rrruark/nixon_phone/readme

The project writeup can be found here: http://robruark.com/projects/nixon_phone/nixon_phone.html
