rrruark/nixon_phone/end_plate_pcb/nixon.bmp

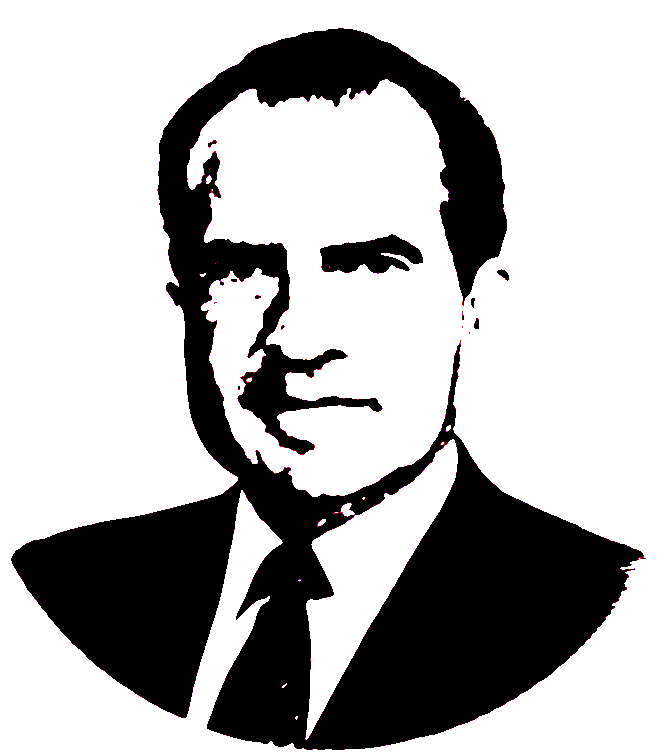
end_plate_pcb/nixon.bmp
