rrruark/nixon_phone/nixon.pdf

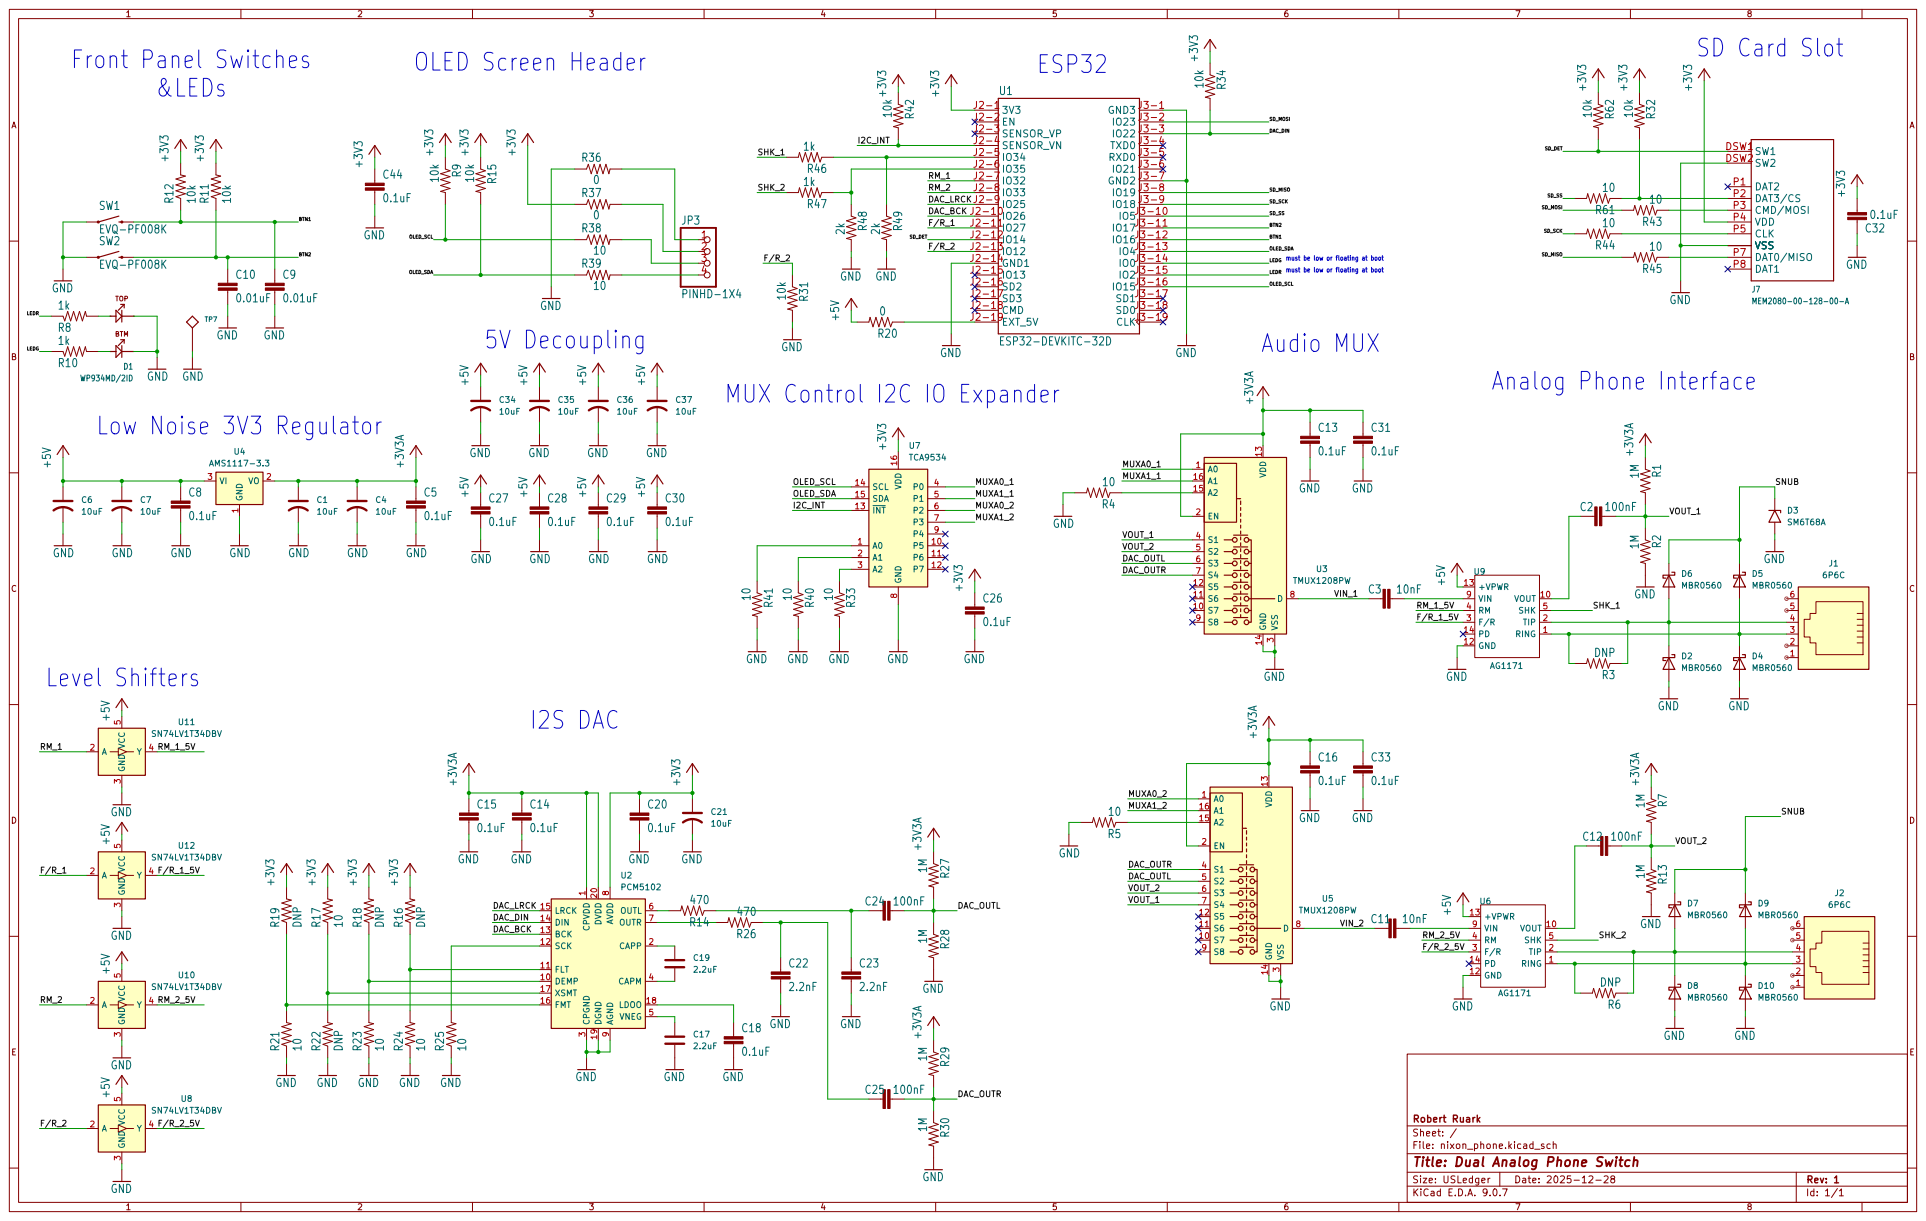
[picture p2: page 1]
