rrruark/nixon_phone/PCB/nixon_phone.kicad_pcb

## KiCad design PCB/nixon_phone.kicad_pcb (2026-05-17)

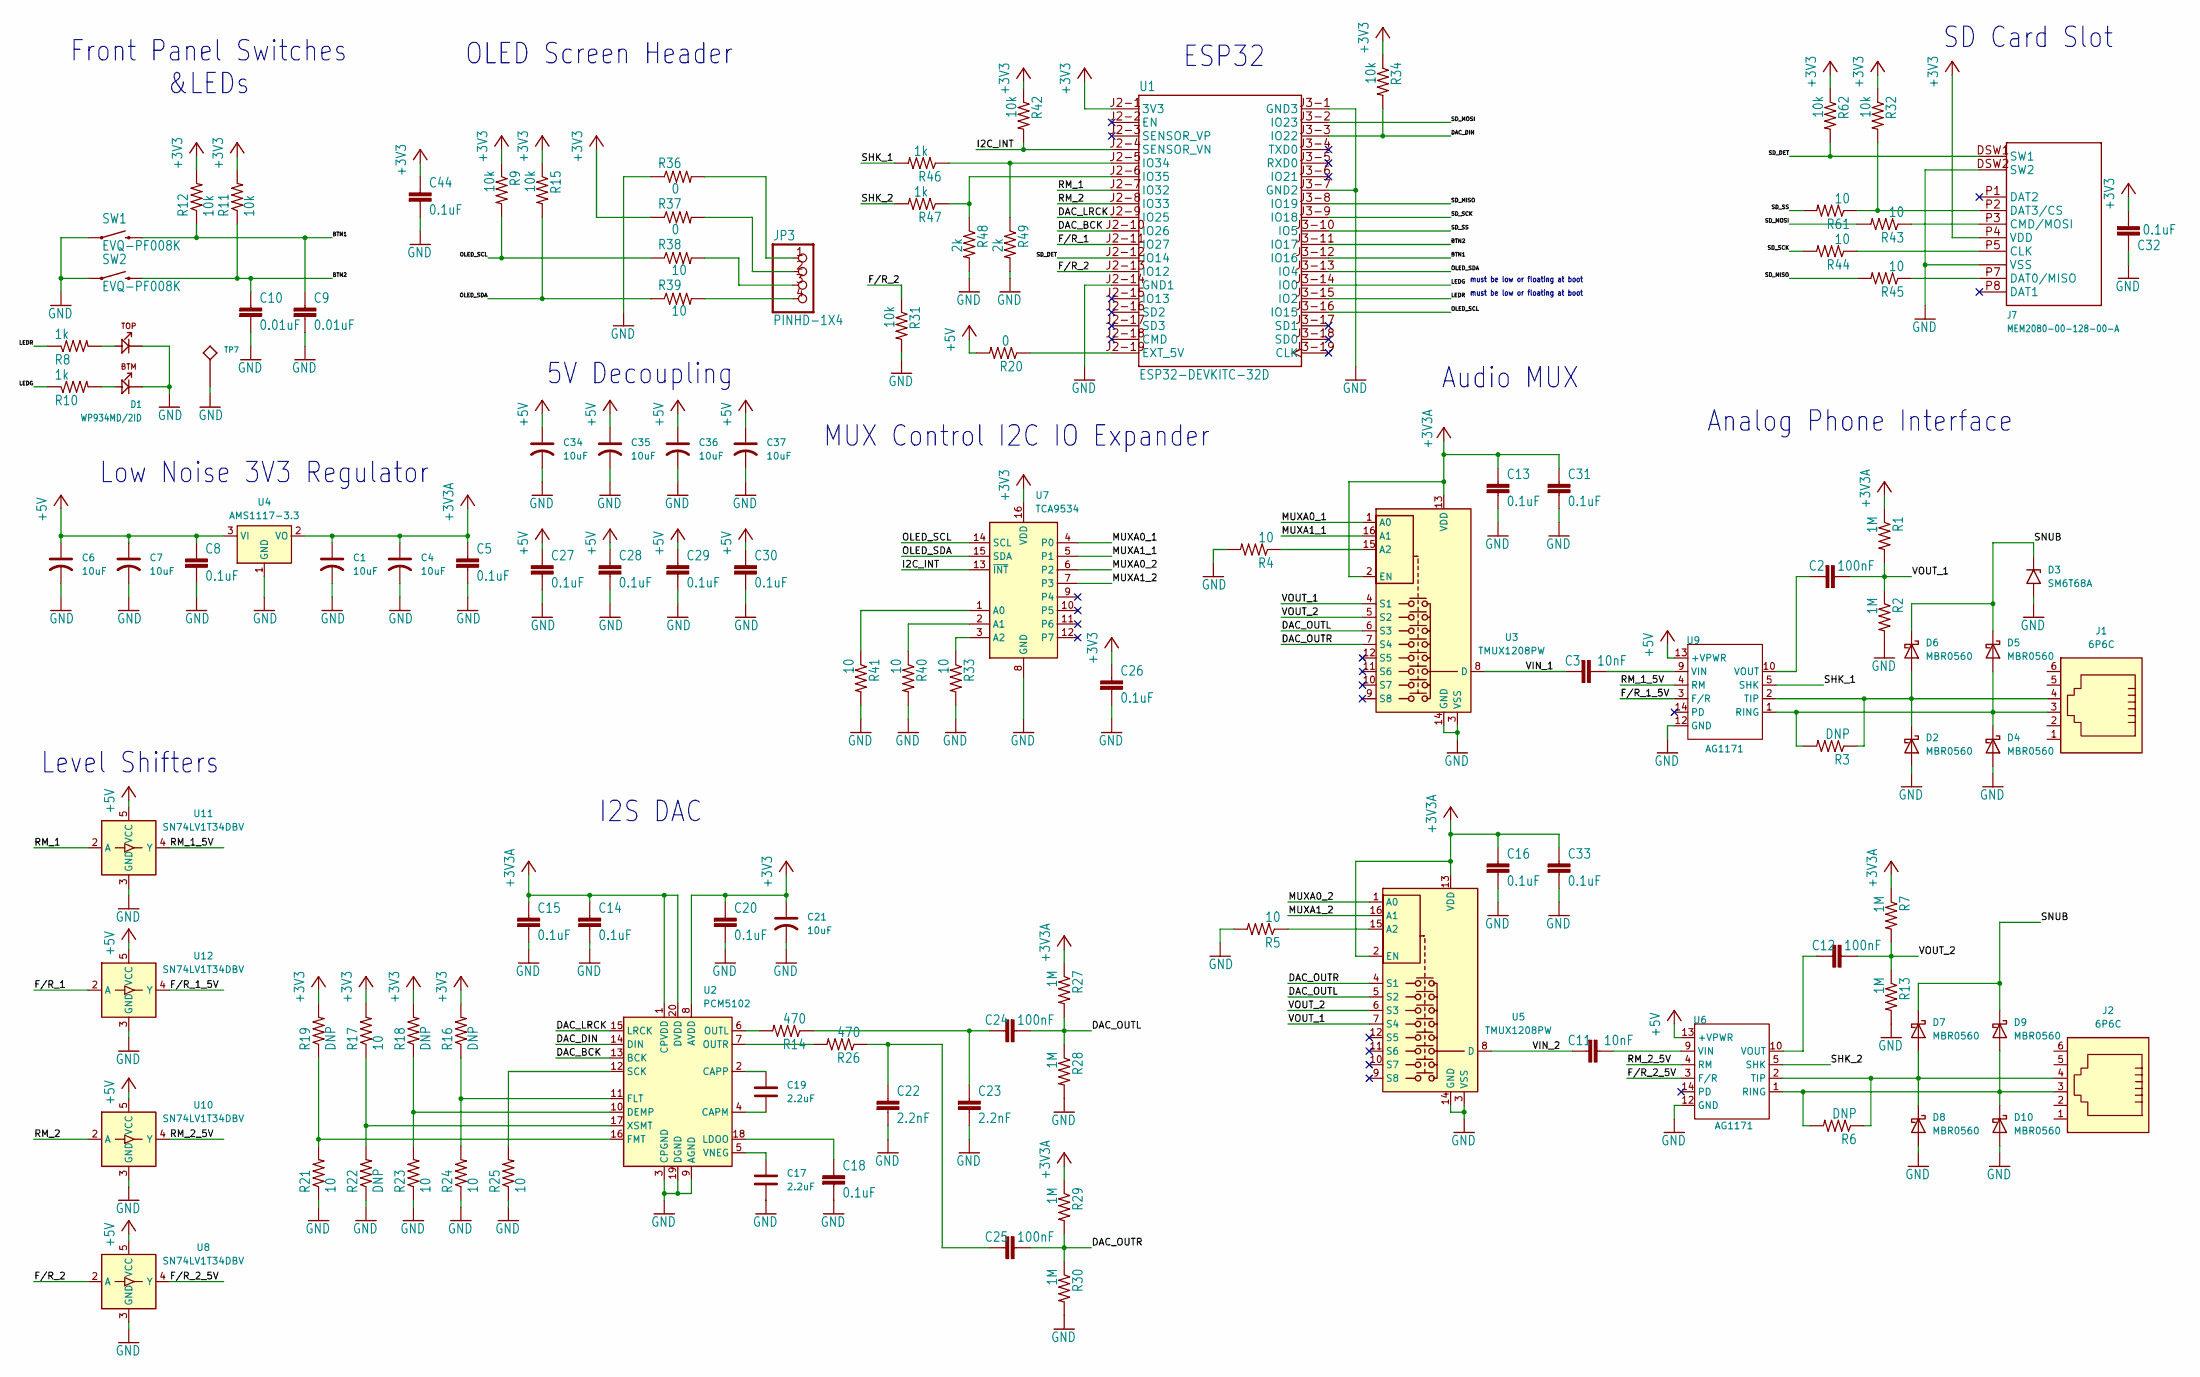
[picture p3: schematic nixon_phone.kicad_sch, Dual Analog Phone Switch]

Parts:
C1, C4, C6, C7, C21, C34, C35, C36, C37: 10uF; C_1206_3216Metric_Pad1.33x1.80mm_HandSolder
C2, C12, C24, C25: 100nF; 0603
C3, C11: 10nF; 0603
C5, C8, C13, C14, C15, C16, C18, C20, C26, C27, C28, C29, C30, C31, C32, C33, C44: 0.1uF; 0603
C9, C10: 0.01uF; 0603
C17, C19: 2.2uF; C_0805_2012Metric
C22, C23: 2.2nF; 0603
D1: WP934MD/2ID; WP934MD_2ID
D2, D4, D5, D6, D7, D8, D9, D10: MBR0560; D_SOD-123
D3: SM6T68A; D_SMB
J1, J2: 6P6C; RJ12_Amphenol_54601-x06_Horizontal
J7: MEM2080-00-128-00-A; MEM2080
JP3: PINHD-1X4; 1X04
R1, R2, R7, R13, R27, R28, R29, R30: 1M; 0603
R3, R6, R16, R18, R19, R22: DNP; 0603
R4, R5, R17, R21, R23, R24, R25, R33, R38, R39, R40, R41, R43, R44, R45, R61: 10; 0603
R8, R10, R46, R47: 1k; 0603
R9, R11, R12, R15, R31, R32, R34, R42, R62: 10k; 0603
R14, R26: 470; 0603
R20, R36, R37: 0; 0603
R48, R49: 2k; 0603
SW1, SW2: EVQ-PF008K
TP7: 5011; 5010
U1: ESP32-DEVKITC-32D; MODULE_ESP32-DEVKITC-32D
U2: PCM5102; TSSOP-20_4.4x6.5mm_P0.65mm
U3, U5: TMUX1208PW; TSSOP-16_4.4x5mm_P0.65mm
U4: AMS1117-3.3; SOT-223-3_TabPin2
U6, U9: AG1171; SIP-18
U7: TCA9534; TSSOP-16_4.4x5mm_P0.65mm
U8, U10, U11, U12: SN74LV1T34DBV; SOT-23-5

Connections:
+3V3: C20.1, C21.1, C26.1, C32.2, C44.1, J7.P4 (VDD), R9.1, R11.2, R12.2, R15.1, R16.2, R17.2, R18.2, R19.2, R32.1, R34.1, R37.1, R42.1, R62.1, U1.J2-1 (3V3), U2.8 (AVDD), U7.16 (VDD)
+3V3A: C1.1, C4.1, C5.1, C13.1, C14.1, C15.1, C16.1, C31.1, C33.1, R1.1, R7.1, R27.1, R29.1, U2.1 (CPVDD), U2.20 (DVDD), U3.2 (EN), U3.13 (VDD), U4.2 (VO), U5.2 (EN), U5.13 (VDD)
+5V: C6.1, C7.1, C8.1, C27.1, C28.1, C29.1, C30.1, C34.1, C35.1, C36.1, C37.1, R20.2, U4.3 (VI), U6.13 (+VPWR), U8.5 (VCC), U9.13 (+VPWR), U10.5 (VCC), U11.5 (VCC), U12.5 (VCC)
/BTN1: C9.1, R12.1, SW1.S2 (2), U1.J3-12 (IO16)
/BTN2: C10.1, R11.1, SW2.S2 (2), U1.J3-11 (IO17)
/DAC_BCK: U1.J2-10 (IO26), U2.13 (BCK)
/DAC_DIN: R34.2, U1.J3-3 (IO22), U2.14 (DIN)
/DAC_LRCK: U1.J2-9 (IO25), U2.15 (LRCK)
/DAC_OUTL: C24.1, R27.2, R28.1, U3.6 (S3), U5.5 (S2)
/DAC_OUTR: C25.1, R29.2, R30.1, U3.7 (S4), U5.4 (S1)
/F/R_1: U1.J2-11 (IO27), U12.2 (A)
/F/R_1_5V: U9.3 (F/R), U12.4 (Y)
/F/R_2: R31.1, U1.J2-13 (IO12), U8.2 (A)
/F/R_2_5V: U6.3 (F/R), U8.4 (Y)
/I2C_INT: R42.2, U1.J2-4 (SENSOR_VN), U7.13 (~INT)
/LEDG: R10.1, U1.J3-14 (IO0)
/LEDR: R8.1, U1.J3-15 (IO2)
/MUXA0_1: U3.1 (A0), U7.4 (P0)
/MUXA0_2: U5.1 (A0), U7.6 (P2)
/MUXA1_1: U3.16 (A1), U7.5 (P1)
/MUXA1_2: U5.16 (A1), U7.7 (P3)
/OLED_SCL: R9.2, R38.1, U1.J3-16 (IO15), U7.14 (SCL)
/OLED_SDA: R15.2, R39.1, U1.J3-13 (IO4), U7.15 (SDA)
/RM_1: U1.J2-7 (IO32), U11.2 (A)
/RM_1_5V: U9.4 (RM), U11.4 (Y)
/RM_2: U1.J2-8 (IO33), U10.2 (A)
/RM_2_5V: U6.4 (RM), U10.4 (Y)
/SD_DET: J7.DSW1 (SW1), R62.2, U1.J2-12 (IO14)
/SD_MISO: R45.2, U1.J3-8 (IO19)
/SD_MOSI: R43.2, U1.J3-2 (IO23)
/SD_SCK: R44.2, U1.J3-9 (IO18)
/SD_SS: R61.2, U1.J3-10 (IO5)
/SHK_1: R46.2, U9.5 (SHK)
/SHK_2: R47.2, U6.5 (SHK)
/SNUB: D3.1 (A1), D5.1 (K), D6.1 (K), D7.1 (K), D9.1 (K)
/VIN_1: C3.2, U3.8 (D)
/VIN_2: C11.2, U5.8 (D)
/VOUT_1: C2.1, R1.2, R2.1, U3.4 (S1), U5.7 (S4)
/VOUT_2: C12.1, R7.2, R13.1, U3.5 (S2), U5.6 (S3)
GND: C1.2, C4.2, C5.2, C6.2, C7.2, C8.2, C9.2, C10.2, C13.2, C14.2, C15.2, C16.2, C17.2, C18.2, C20.2, C21.2, C22.2, C23.2, C26.2, C27.2, C28.2, C29.2, C30.2, C31.2, C32.1, C33.2, C34.2, C35.2, C36.2, C37.2, C44.2, D1.K1, D1.K2, D2.2 (A), D3.2 (A2), D4.2 (A), D8.2 (A), D10.2 (A), J7.C1 (VSS), J7.C2 (VSS), J7.C3 (VSS), J7.C4 (VSS), J7.DSW2 (SW2), J7.P6 (VSS), R2.2, R4.2, R5.2, R13.2, R21.1, R22.1, R23.1, R24.1, R25.1, R28.2, R30.2, R31.2, R33.2, R36.1, R40.2, R41.2, R48.2, R49.2, SW1.S1 (1), SW2.S1 (1), TP7.P$1, U1.J2-14 (GND1), U1.J3-1 (GND3), U1.J3-7 (GND2), U2.3 (CPGND), U2.9 (AGND), U2.19 (DGND), U3.3 (VSS), U3.14 (GND), U4.1 (GND), U5.3 (VSS), U5.14 (GND), U6.12 (GND), U7.8 (GND), U8.3 (GND), U9.12 (GND), U10.3 (GND), U11.3 (GND), U12.3 (GND)
unnamed: C22.1, C25.2, R26.1
unnamed: C23.1, C24.2, R14.1
unnamed: D1.A1, R10.2
unnamed: D1.A2, R8.2
unnamed: D2.1 (K), D6.2 (A), J1.4, R3.1, U9.2 (TIP)
unnamed: D4.1 (K), D5.2 (A), J1.3, R3.2, U9.1 (RING)
unnamed: D7.2 (A), D8.1 (K), J2.4, R6.1, U6.2 (TIP)
unnamed: D9.2 (A), D10.1 (K), J2.3, R6.2, U6.1 (RING)
unnamed: J7.P5 (CLK), R44.1
unnamed: J7.P3 (CMD/MOSI), R43.1
unnamed: J7.P7 (DAT0/MISO), R45.1
unnamed: J7.P2 (DAT3/CS), R32.2, R61.1
unnamed: JP3.1, R36.2
unnamed: JP3.2, R37.2
unnamed: JP3.3, R38.2
unnamed: JP3.4, R39.2
unnamed: R20.1, U1.J2-19 (EXT_5V)
unnamed: R46.1, R49.1, U1.J2-5 (IO34)
unnamed: R47.1, R48.1, U1.J2-6 (IO35)
unnamed: C19.2, U2.4 (CAPM)
unnamed: C19.1, U2.2 (CAPP)
unnamed: R18.1, R23.2, U2.10 (DEMP)
unnamed: R16.1, R24.2, U2.11 (FLT)
unnamed: R19.1, R21.2, U2.16 (FMT)
unnamed: C18.1, U2.18 (LDOO)
unnamed: R14.2, U2.6 (OUTL)
unnamed: R26.2, U2.7 (OUTR)
unnamed: R25.2, U2.12 (SCK)
unnamed: C17.1, U2.5 (VNEG)
unnamed: R17.1, R22.2, U2.17 (XSMT)
unnamed: R4.1, U3.15 (A2)
unnamed: R5.1, U5.15 (A2)
unnamed: C11.1, U6.9 (VIN)
unnamed: C12.2, U6.10 (VOUT)
unnamed: R41.1, U7.1 (A0)
unnamed: R40.1, U7.2 (A1)
unnamed: R33.1, U7.3 (A2)
unnamed: C3.1, U9.9 (VIN)
unnamed: C2.2, U9.10 (VOUT)

Notes on the sheet:
SD Card Slot
Front Panel Switches &LEDs
must be low or floating at boot
Low Noise 3V3 Regulator
Audio MUX
I2S DAC
5V Decoupling
OLED Screen Header
MUX Control I2C IO Expander
Level Shifters
ESP32
Analog Phone Interface

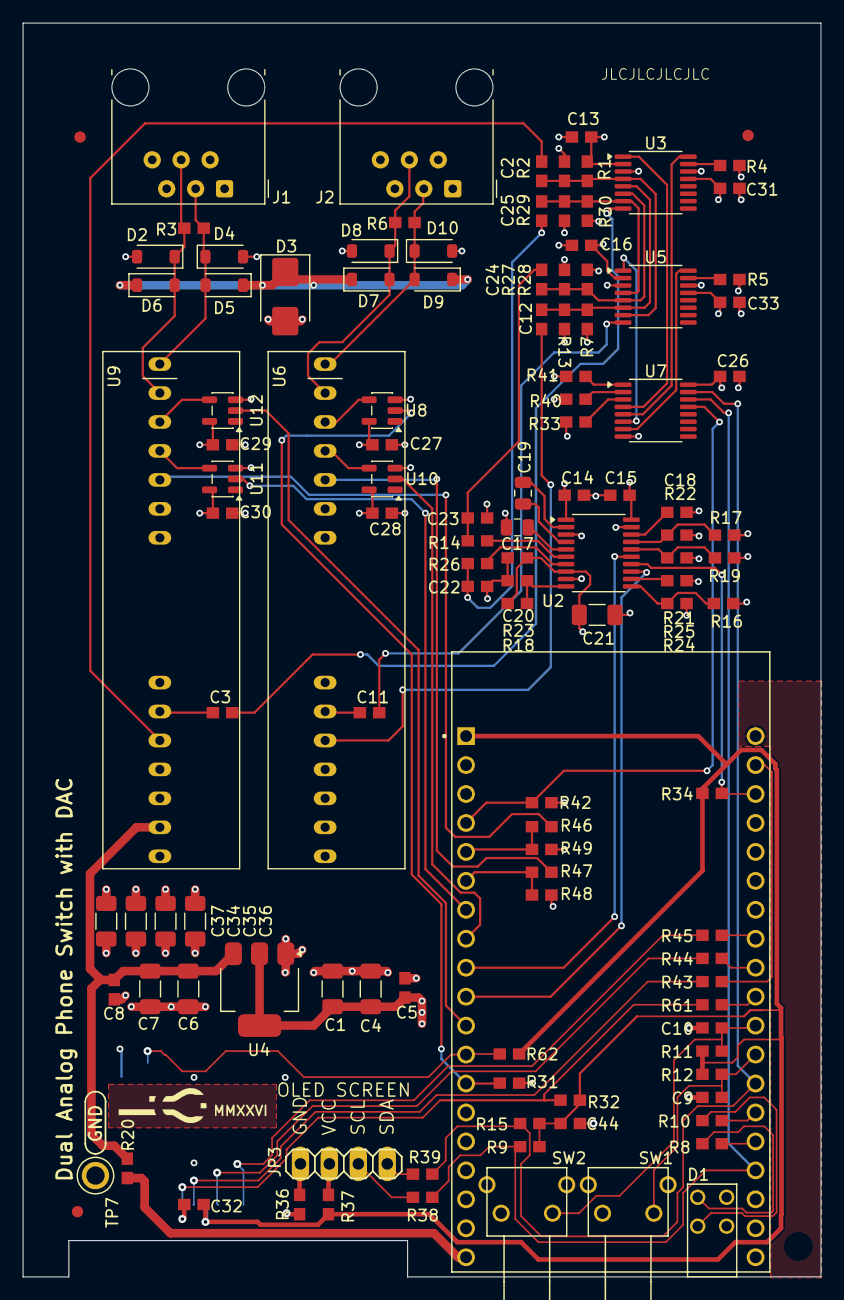
[picture p4: board nixon_phone.kicad_pcb from above]

Board: 4 copper layers, 70.0 x 110.0 mm, 117 parts (1 on the bottom side), 79 nets.
